ilyakolb/ilyakolb.github.io/_publications/jgcamp8_paper.md

---
title: "Fast and sensitive GCaMP calcium indicators for imaging neural populations"
collection: publications
permalink: jgcamp8_paper
excerpt: 'Calcium imaging with protein-based indicators1,2 is widely used to follow neural activity in intact nervous systems, but current protein sensors report neural activity at timescales much slower than electrical signalling and are limited by trade-offs between sensitivity and kinetics. Here we used large-scale screening and structure-guided mutagenesis to develop and optimize several fast and sensitive GCaMP-type indicators3–8. The resulting ‘jGCaMP8’ sensors, based on the calcium-binding protein calmodulin and a fragment of endothelial nitric oxide synthase, have ultra-fast kinetics (half-rise times of 2 ms) and the highest sensitivity for neural activity reported for a protein-based calcium sensor. jGCaMP8 sensors will allow tracking of large populations of neurons on timescales relevant to neural computation. [<a href="https://www.nature.com/articles/d41586-023-00704-y/"><b>[News and Views]</b></a>'
date: March 2023
venue: 'Nature'
paperurl: 'https://www.nature.com/articles/d41586-023-00704-y.pdf'
citation: 'Zhang, Yan, Márton Rózsa, Yajie Liang, Daniel Bushey, Ziqiang Wei, Jihong Zheng, Daniel Reep, et al. “Fast and Sensitive GCaMP Calcium Indicators for Imaging Neural Populations.” <i>Nature</i> 615, no. 7954 (March 2023): 884–91. https://doi.org/10.1038/s41586-023-05828-9.'

---
