ilyakolb/ilyakolb.github.io/patcherBot.md

---
title: "PatcherBot: walk-away automated patch-clamp robotics"
excerpt: "PatcherBot: walk-away automated patch-clamp robotics"
sitemap: true
permalink: /patcherBot/
author_profile: true
---

## About
 - Enables automated patch-clamp recordings in cultured cells, brain slices and *in vivo*
 - Autonomously performs experiments for 3+ hours with no human intervention
 - Uses computer vision and automated pipette cleaning to close the loop

## Demonstration video
<iframe width="560" height="315" src="https://www.youtube.com/embed/nqFYfrU-XBE" title="YouTube video player" frameborder="0" allow="accelerometer; autoplay; clipboard-write; encrypted-media; gyroscope; picture-in-picture" allowfullscreen></iframe>

*Two pipettes independently patch-clamp multiple HEK cells on a glass cover slip sequentially without human intervention over the span of 27 minutes. Green light indicates successful whole-cell recording.*

### Other patcherBot videos
[[Timelapse experiment](https://www.youtube.com/watch?v=CGZxwwHRhpE)]
[[In vivo experiment](https://www.youtube.com/watch?v=CGZxwwHRhpE)]
[[Single-pipette experiment](https://www.youtube.com/watch?v=CGZxwwHRhpE)]

## Details

For more details on implementation, see the [PatcherBot paper](https://iopscience.iop.org/article/10.1088/1741-2552/ab1834) and the [pipette cleaning paper](https://www.nature.com/articles/srep35001)
