ilyakolb/ilyakolb.github.io/wellStim.md

---
title: "wellStim: current stimulator for 24-well plates"
excerpt: "wellStim: current stimulator for 24-well plates"
sitemap: true
permalink: /wellStim/
author_profile: true
---

## About
 - Provides ability to easily program stimulation sequences to be delivered to each well
 - Compatible with simultaneous imaging and drug delivery
 - Integrates with Micro-Manager for fully automated plate acquisition
 - Can be controlled by software or in standalone mode, making it easily portable 
 - Advanced features (trigger in/out, sync pulses)
