ilyakolb/ilyakolb.github.io/_publications/igaba2_preprint.md

---
title: "Improved GABA (γ-aminobutyric acid) Indicators for Synaptic Imaging"
collection: publications
permalink: igaba2_preprint
excerpt: 'iGABASnFR2 is the current (2022) generation of GABA-Sensing Fluorescent Reporters developed at HHMI''s Janelia Research Campus. Other sensor technologies such as SF-iGluSnFR, jGCaMP8, and jRGECO are optimized for excitatory synaptic transmission and action potentials. iGABASnFr complements these technologies with the ability to detect inhibitory synaptic transmission and inhibitory post-synaptic currents. iGABASnFr2 has the best performance among GABA indicators and is completely genetically coded, which is optimal for in vivo use.'
date: September 2022
venue: 'Figshare'
paperurl: 'https://janelia.figshare.com/articles/dataset Optimization_of_genetically_encoded_GABA_indicator/19709311'
citation: 'Kolb, Ilya; Hasseman, Jeremy; Tsegaye, Getahun; Tsang, Arthur; Reep, Daniel; Zheng, Jihong; et al. (2022). Optimization of genetically encoded GABA indicator. Janelia Research Campus. Dataset. https://doi.org/10.25378/janelia.19709311.v3'

---
