ilyakolb/ilyakolb.github.io/projects/96well/images/MIB-box-back.png

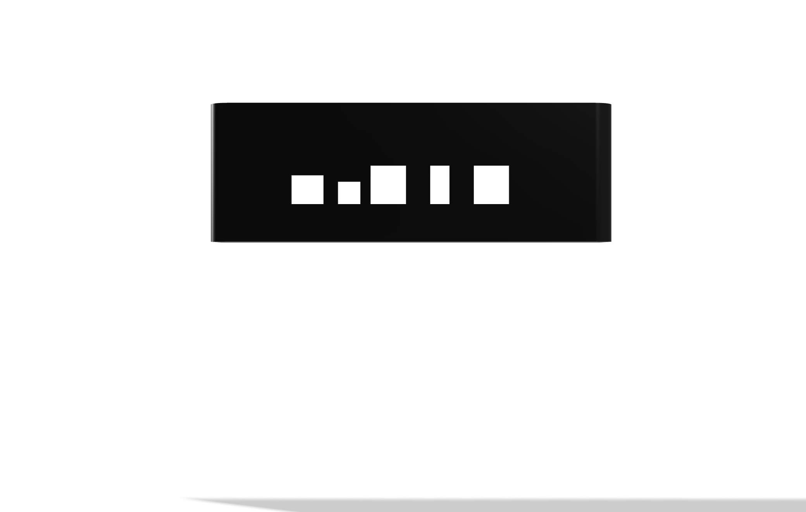
projects/96well/images/MIB-box-back.png
