ilyakolb/ilyakolb.github.io/projects/96well/images/MIB-box-front.png

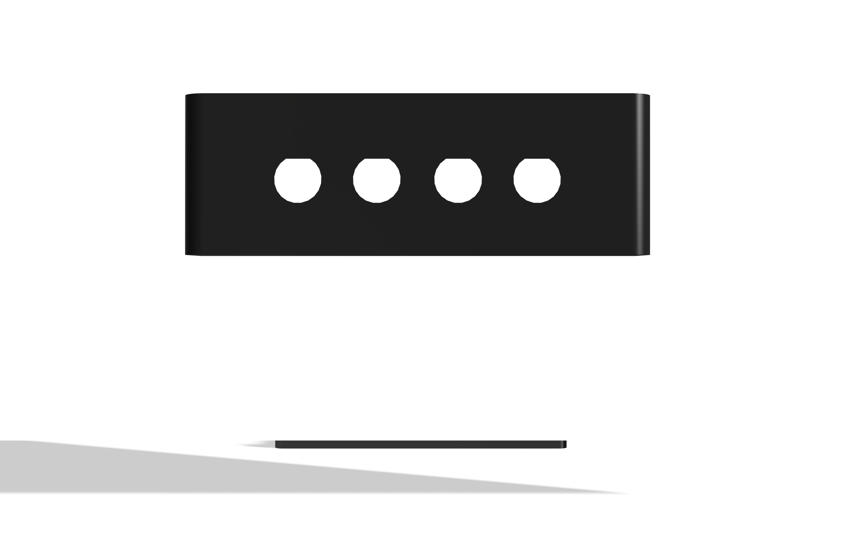
projects/96well/images/MIB-box-front.png
