ilyakolb/ilyakolb.github.io/projects/96well/images/MIB-box-top.png

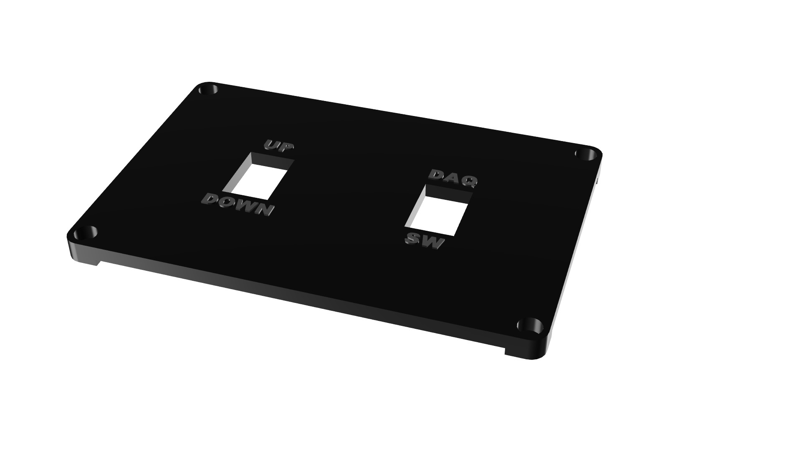
projects/96well/images/MIB-box-top.png
