ilyakolb/ilyakolb.github.io/projects/96well/ECAD/MIB_BOM.xlsx

Sheet: prelim-bom
Reference | Value | Footprint | Datasheet | Sim.Device | Sim.Pins | Qty | Part number (Digikey; Mouser where indicated)
R3, R4, R9, R10 | 330 | Resistor_THT:R_Axial_DIN0204_L3.6mm_D1.6mm_P7.62mm_Horizontal | ~ |  |  | 4 | Have
R1, R2, R5-R8 | 10k | Resistor_THT:R_Axial_DIN0204_L3.6mm_D1.6mm_P7.62mm_Horizontal | ~ |  |  | 6 | Have
D1, D2 | 1N4001 | Diode_THT:D_DO-41_SOD81_P10.16mm_Horizontal | http://www.vishay.com/docs/88503/1n4001.pdf | D | 1=K 2=A | 2 | Have
PWR_IN1 | Barrel_Jack_MountingPin | Connector_BarrelJack:BarrelJack_CUI_PJ-063AH_Horizontal_CircularHoles | ~ |  |  | 1 | PJ-063AH
DAQ_IN_DWN1 | Conn_Coaxial | Connector_Coaxial:BNC_Amphenol_B6252HB-NPP3G-50_Horizontal | ~ |  |  | 1 | ARF1691-ND
DAQ_IN_UP1 | Conn_Coaxial | Connector_Coaxial:BNC_Amphenol_B6252HB-NPP3G-50_Horizontal | ~ |  |  | 1 | ARF1691-ND
DWN_LIM_OUT1 | Conn_Coaxial | Connector_Coaxial:BNC_Amphenol_B6252HB-NPP3G-50_Horizontal | ~ |  |  | 1 | ARF1691-ND
UP_LIM_OUT1 | Conn_Coaxial | Connector_Coaxial:BNC_Amphenol_B6252HB-NPP3G-50_Horizontal | ~ |  |  | 1 | ARF1691-ND
DWN_RLY1 | FINDER-34.51 | Relay_THT:Relay_SPDT_Finder_34.51_Vertical | https://gfinder.findernet.com/public/attachments/34/EN/S34USAEN.pdf |  |  | 1 | APF30305 (Mouser)
UP_RLY1 | FINDER-34.51 | Relay_THT:Relay_SPDT_Finder_34.51_Vertical | https://gfinder.findernet.com/public/attachments/34/EN/S34USAEN.pdf |  |  | 1 | APF30305 (Mouser)
Q1-Q4 | IRLB8721PBF | Package_TO_SOT_THT:TO-220-3_Vertical | http://www.infineon.com/dgdl/irlb8721pbf.pdf?fileId=5546d462533600a40153566056732591 |  |  | 4 | IRLB8721PBF-ND
M1 | Motor_DC_ALT | TerminalBlock_Phoenix:TerminalBlock_Phoenix_MPT-0,5-2-2.54_1x02_P2.54mm_Horizontal | ~ |  |  | 1 | 277-1273-ND
DWN_LIM1 | PM-25 | TerminalBlock_Phoenix:TerminalBlock_Phoenix_MPT-0,5-4-2.54_1x04_P2.54mm_Horizontal |  |  |  | 1 | 277-1275-ND
UP_LIM1 | PM-25 | TerminalBlock_Phoenix:TerminalBlock_Phoenix_MPT-0,5-4-2.54_1x04_P2.54mm_Horizontal |  |  |  | 1 | 277-1275-ND
SW_DAQ_OR_MAN_1 | SW_DAQ_OR_MAN | TerminalBlock_Phoenix:TerminalBlock_Phoenix_MPT-0,5-6-2.54_1x06_P2.54mm_Horizontal | ~ |  |  | 1 | 277-1277-ND
SW_DWN_LIM_EN1 | SW_DIP_x02 | Button_Switch_THT:SW_DIP_SPSTx02_Slide_6.7x6.64mm_W7.62mm_P2.54mm_LowProfile | ~ |  |  | 1 | 2223-DS01-254-S-02BE-ND
SW_UP_LIM_EN1 | SW_DIP_x02 | Button_Switch_THT:SW_DIP_SPSTx02_Slide_6.7x6.64mm_W7.62mm_P2.54mm_LowProfile | ~ |  |  | 1 | 2223-DS01-254-S-02BE-ND
SW_UPDWN1 | SW_Push_SPDT | TerminalBlock_Phoenix:TerminalBlock_Phoenix_MPT-0,5-3-2.54_1x03_P2.54mm_Horizontal | ~ |  |  | 1 | 277-1274-ND

Sheet: v2.0
Reference | Value | Footprint | Qty | Part number (Digikey; Mouser where indicated)
R5-R7 | 330 | Resistor_THT:R_Axial_DIN0204_L3.6mm_D1.6mm_P7.62mm_Horizontal | 4 | S330HTR-ND
R1-R4 | 10k | Resistor_THT:R_Axial_DIN0204_L3.6mm_D1.6mm_P7.62mm_Horizontal | 6 | S10KHTR-ND
D1, D2 | 1N4001 | Diode_THT:D_DO-41_SOD81_P10.16mm_Horizontal | 2 | 2156-1N4001-FSTR-ND
PWR_IN1 | Barrel_Jack_MountingPin | Connector_BarrelJack:BarrelJack_CUI_PJ-063AH_Horizontal_CircularHoles | 1 | PJ-063AH
DAQ_IN_DWN1 | Conn_Coaxial | Connector_Coaxial:BNC_Amphenol_B6252HB-NPP3G-50_Horizontal | 1 | ARF1691-ND
DAQ_IN_UP1 | Conn_Coaxial | Connector_Coaxial:BNC_Amphenol_B6252HB-NPP3G-50_Horizontal | 1 | ARF1691-ND
DWN_LIM_OUT1 | Conn_Coaxial | Connector_Coaxial:BNC_Amphenol_B6252HB-NPP3G-50_Horizontal | 1 | ARF1691-ND
UP_LIM_OUT1 | Conn_Coaxial | Connector_Coaxial:BNC_Amphenol_B6252HB-NPP3G-50_Horizontal | 1 | ARF1691-ND
DWN_RLY1 | FINDER-34.51 | Relay_THT:Relay_SPDT_Finder_34.51_Vertical | 1 | APF30305 (Mouser)
UP_RLY1 | FINDER-34.51 | Relay_THT:Relay_SPDT_Finder_34.51_Vertical | 1 | APF30305 (Mouser)
Q1-Q2 |  | Package_TO_SOT_THT:TO-220-3_Vertical | 4 | IRLB8721PBF-ND
M1 | Motor_DC_ALT | TerminalBlock_Phoenix:TerminalBlock_Phoenix_MPT-0,5-2-2.54_1x02_P2.54mm_Horizontal | 1 | 277-1273-ND
DWN_LIM1 | PM-25 | TerminalBlock_Phoenix:TerminalBlock_Phoenix_MPT-0,5-4-2.54_1x04_P2.54mm_Horizontal | 1 | 277-1275-ND
UP_LIM1 | PM-25 | TerminalBlock_Phoenix:TerminalBlock_Phoenix_MPT-0,5-4-2.54_1x04_P2.54mm_Horizontal | 1 | 277-1275-ND
SW_DAQ_OR_MAN_1 | SW_DAQ_OR_MAN | TerminalBlock_Phoenix:TerminalBlock_Phoenix_MPT-0,5-6-2.54_1x06_P2.54mm_Horizontal | 1 | 277-1277-ND
SW_DWN_LIM_EN1 | SW_DIP_x02 | Button_Switch_THT:SW_DIP_SPSTx02_Slide_6.7x6.64mm_W7.62mm_P2.54mm_LowProfile | 1 | 2223-DS01-254-S-02BE-ND
SW_UP_LIM_EN1 | SW_DIP_x02 | Button_Switch_THT:SW_DIP_SPSTx02_Slide_6.7x6.64mm_W7.62mm_P2.54mm_LowProfile | 1 | 2223-DS01-254-S-02BE-ND
SW_UPDWN1 | SW_Push_SPDT | TerminalBlock_Phoenix:TerminalBlock_Phoenix_MPT-0,5-3-2.54_1x03_P2.54mm_Horizontal | 1 | 277-1274-ND
N/A | 5V/5W power supply | N/A | 1 | GS06U-1P1J

Sheet: v1.0
Status | # | Reference | Qty | Value | Footprint | DNP
Not placed | 1 | C1 | 1 | 10uF | Capacitor_THT:CP_Radial_D5.0mm_P2.50mm
Not placed | 2 | C2 | 1 | 0.1uF | Capacitor_THT:C_Axial_L3.8mm_D2.6mm_P7.50mm_Horizontal
Not placed | 3 | D1, D2 | 2 | 1N4001 | Diode_THT:D_DO-41_SOD81_P10.16mm_Horizontal
Placed | 4 | D3 | 1 | LED | ik_lib:LED_W6mm_L9.2mm_Pitch2.54mm
Placed | 5 | DAQ_IN_DWN1, DAQ_IN_UP1, DWN_LIM_OUT1, UP_LIM_OUT1 | 4 | Conn_Coaxial | Connector_Coaxial:BNC_Amphenol_B6252HB-NPP3G-50_Horizontal
Placed | 6 | DWN_LIM1, UP_LIM1 | 2 | PM-25 | TerminalBlock_Phoenix:TerminalBlock_Phoenix_MPT-0,5-4-2.54_1x04_P2.54mm_Horizontal
Placed | 7 | DWN_RLY1, UP_RLY1 | 2 | FINDER-34.51 | Relay_THT:Relay_SPDT_Finder_34.51_Vertical
Placed | 8 | M1 | 1 | Motor_DC_ALT | TerminalBlock_Phoenix:TerminalBlock_Phoenix_MPT-0,5-2-2.54_1x02_P2.54mm_Horizontal
Placed | 9 | PWR_IN1 | 1 | Barrel_Jack_MountingPin | Connector_BarrelJack:BarrelJack_CUI_PJ-063AH_Horizontal_CircularHoles
Placed | 10 | Q1, Q2, Q3, Q4 | 4 | IRLB8721PBF | Package_TO_SOT_THT:TO-220-3_Vertical
Not placed | 11 | R1, R2, R5, R6, R7, R8 | 6 | 10k | Resistor_THT:R_Axial_DIN0204_L3.6mm_D1.6mm_P7.62mm_Horizontal
Not placed | 12 | R3, R4, R9, R10, R11 | 5 | 330 | Resistor_THT:R_Axial_DIN0204_L3.6mm_D1.6mm_P7.62mm_Horizontal
Placed | 13 | SW_DAQ_OR_MAN_1 | 1 | SW_DAQ_OR_MAN | TerminalBlock_Phoenix:TerminalBlock_Phoenix_MPT-0,5-6-2.54_1x06_P2.54mm_Horizontal
Placed | 14 | SW_DWN_LIM_EN1, SW_UP_LIM_EN1 | 2 | SW_DIP_x02 | Button_Switch_THT:SW_DIP_SPSTx02_Slide_6.7x6.64mm_W7.62mm_P2.54mm_LowProfile
Placed | 15 | SW_UPDWN1 | 1 | SW_Push_SPDT | TerminalBlock_Phoenix:TerminalBlock_Phoenix_MPT-0,5-3-2.54_1x03_P2.54mm_Horizontal
