ilyakolb/ilyakolb.github.io/projects/96well/CAD/MIB-lid.stl

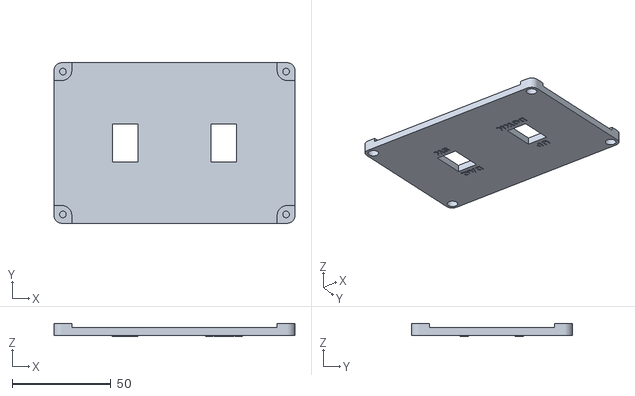
[picture p11: CAD file, 2024-07-17]
projects/96well/CAD/MIB-lid.stl
121.9 x 81.3 x 6.50
