ilyakolb/ilyakolb.github.io/projects/96well/CAD/actuator-mounting-bracket-v39.stl

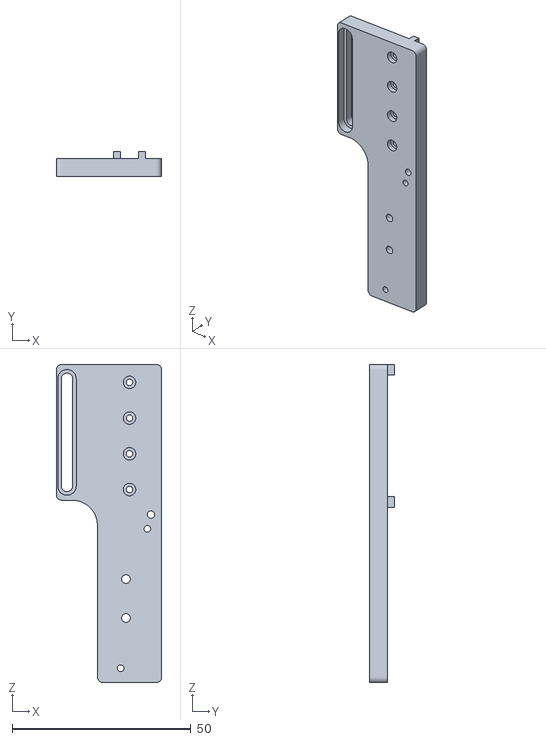
[picture p12: CAD file, 2024-07-17]
projects/96well/CAD/actuator-mounting-bracket-v39.stl
29.5 x 7.00 x 89.0
