ilyakolb/ilyakolb.github.io/projects/96well/CAD/actuator-retention-bracket-v2.stl

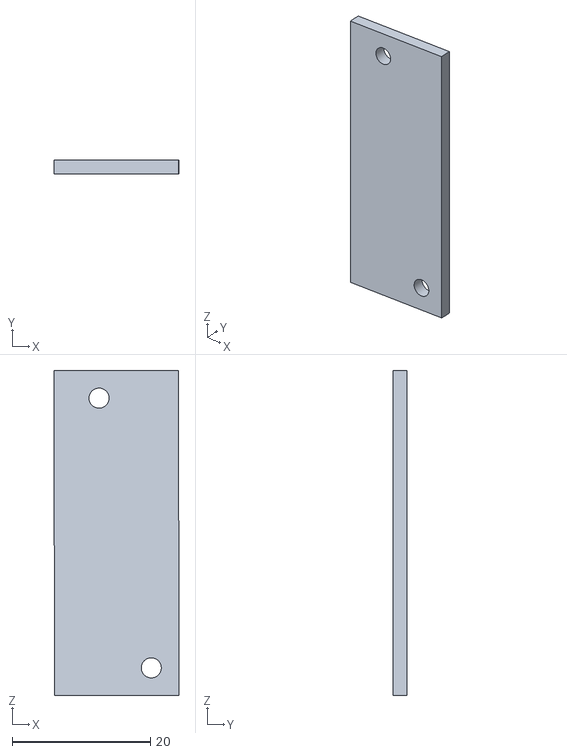
[picture p13: CAD file, 2024-07-17]
projects/96well/CAD/actuator-retention-bracket-v2.stl
18.1 x 2.00 x 47.0
