ilyakolb/ilyakolb.github.io/projects/96well/CAD/electrode-carriage-v20.stl

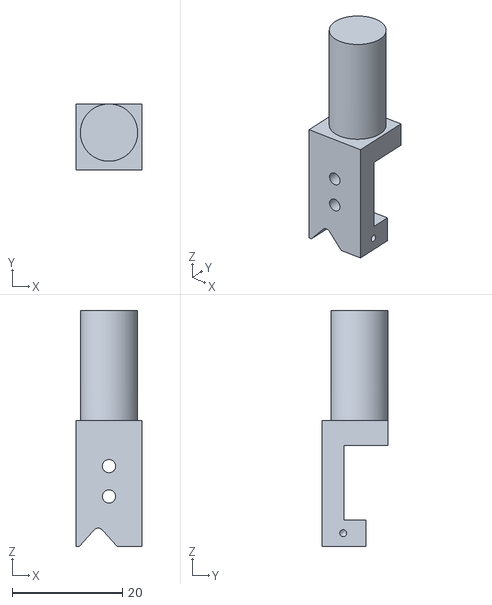
[picture p14: CAD file, 2024-07-17]
projects/96well/CAD/electrode-carriage-v20.stl
11.9 x 12.0 x 42.8
