ilyakolb/ilyakolb.github.io/projects/96well/CAD/condenser-mount-v12.stl

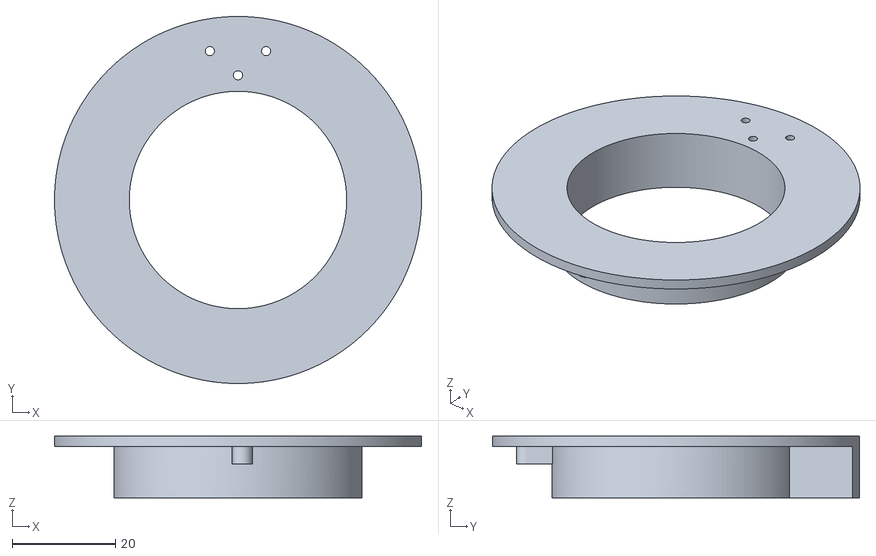
[picture p15: CAD file, 2024-07-17]
projects/96well/CAD/condenser-mount-v12.stl
71.1 x 71.1 x 12.0
