ilyakolb/ilyakolb.github.io/projects/96well/CAD/MIB-body.stl

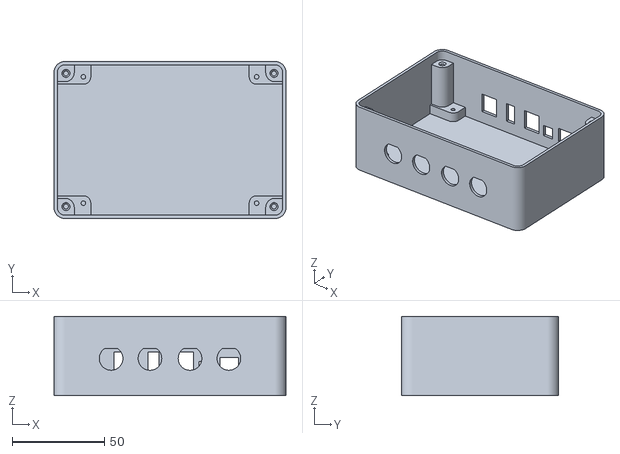
[picture p16: CAD file, 2024-07-17]
projects/96well/CAD/MIB-body.stl
125.9 x 85.3 x 43.0
