ilyakolb/ilyakolb.github.io/projects/96well/CAD/electrode-housing-v5.stl

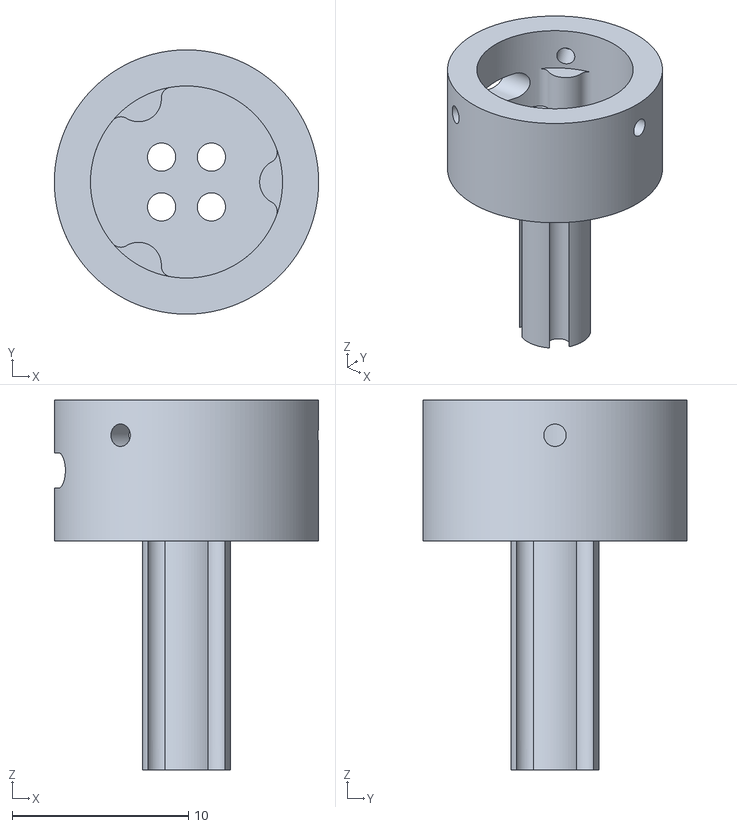
[picture p17: CAD file, 2024-07-17]
projects/96well/CAD/electrode-housing-v5.stl
15.0 x 15.0 x 21.0
