ilyakolb/ilyakolb.github.io/projects/96well/ECAD/interface-board.kicad_pcb

## KiCad design projects/96well/ECAD/interface-board.kicad_pcb (2024-07-17)

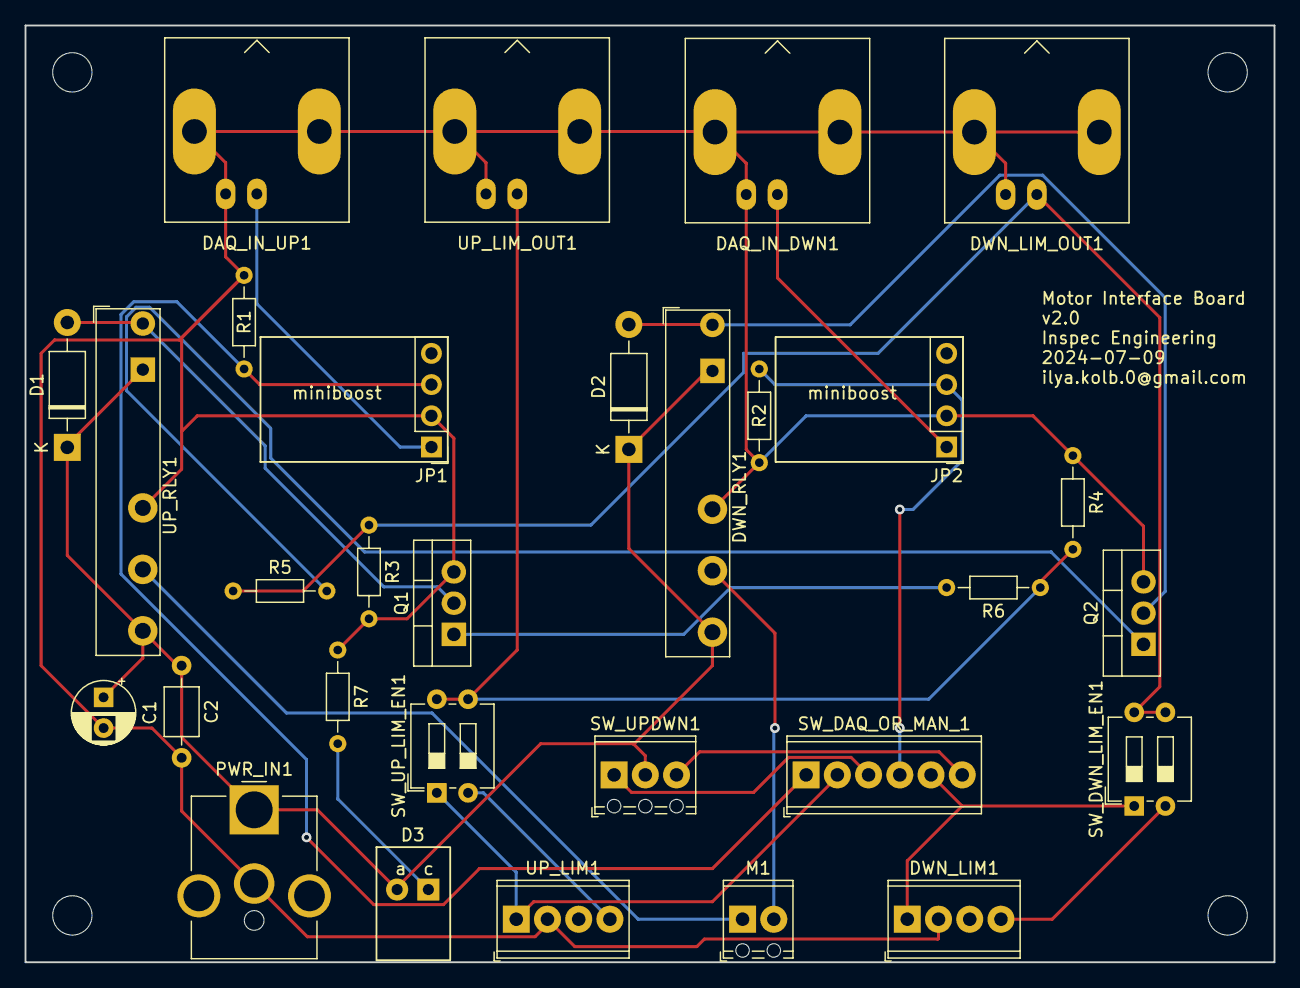
[picture p18: board interface-board.kicad_pcb from above]

Board: 2 copper layers, 101.6 x 76.2 mm, 30 parts (0 on the bottom side), 21 nets.

Parts:
C1: 10uF; CP_Radial_D5.0mm_P2.50mm
C2: 0.1uF; C_Axial_L3.8mm_D2.6mm_P7.50mm_Horizontal
D1, D2: 1N4001; D_DO-41_SOD81_P10.16mm_Horizontal
D3: LED; LED_W6mm_L9.2mm_Pitch2.54mm
DAQ_IN_DWN1: Conn_Coaxial; BNC_Amphenol_B6252HB-NPP3G-50_Horizontal
DAQ_IN_UP1: Conn_Coaxial; BNC_Amphenol_B6252HB-NPP3G-50_Horizontal
DWN_LIM1: PM-25; TerminalBlock_Phoenix_MPT-0,5-4-2.54_1x04_P2.54mm_Horizontal
DWN_LIM_OUT1: Conn_Coaxial; BNC_Amphenol_B6252HB-NPP3G-50_Horizontal
DWN_RLY1: FINDER-34.51; Relay_SPDT_Finder_34.51_Vertical
JP1, JP2: HEADER-1X4ROUND; PinHeader_1x04_P2.54mm_Vertical
M1: Motor_DC_ALT; TerminalBlock_Phoenix_MPT-0,5-2-2.54_1x02_P2.54mm_Horizontal
PWR_IN1: Barrel_Jack_MountingPin; BarrelJack_CUI_PJ-063AH_Horizontal_CircularHoles
Q1, Q2: IRLB8721PBF; TO-220-3_Vertical
R1, R2, R3, R4: 10k; R_Axial_DIN0204_L3.6mm_D1.6mm_P7.62mm_Horizontal
R5, R6, R7: 330; R_Axial_DIN0204_L3.6mm_D1.6mm_P7.62mm_Horizontal
SW_DAQ_OR_MAN_1: SW_DAQ_OR_MAN; TerminalBlock_Phoenix_MPT-0,5-6-2.54_1x06_P2.54mm_Horizontal
SW_DWN_LIM_EN1: SW_DIP_x02; SW_DIP_SPSTx02_Slide_6.7x6.64mm_W7.62mm_P2.54mm_LowProfile
SW_UPDWN1: SW_Push_SPDT; TerminalBlock_Phoenix_MPT-0,5-3-2.54_1x03_P2.54mm_Horizontal
SW_UP_LIM_EN1: SW_DIP_x02; SW_DIP_SPSTx02_Slide_6.7x6.64mm_W7.62mm_P2.54mm_LowProfile
UP_LIM1: PM-25; TerminalBlock_Phoenix_MPT-0,5-4-2.54_1x04_P2.54mm_Horizontal
UP_LIM_OUT1: Conn_Coaxial; BNC_Amphenol_B6252HB-NPP3G-50_Horizontal
UP_RLY1: FINDER-34.51; Relay_SPDT_Finder_34.51_Vertical

Connections:
GND: C1.2, C2.2, DAQ_IN_DWN1.2 (Ext), DAQ_IN_UP1.2 (Ext), DWN_LIM1.2 (GND), DWN_LIM_OUT1.2 (Ext), DWN_RLY1.12, JP1.2 (GND), JP2.2 (GND), PWR_IN1.2, Q1.3 (S), Q2.3 (S), R1.1, R2.1, R3.2, R4.1, R7.1, UP_LIM1.2 (GND), UP_LIM_OUT1.2 (Ext), UP_RLY1.12
unnamed: D1.2 (A), Q1.2 (D), UP_RLY1.A2
unnamed: D2.2 (A), DWN_RLY1.A2, Q2.2 (D)
unnamed: D3.1 (K), R7.2
unnamed: DAQ_IN_DWN1.1 (In), JP2.1 (VIN)
unnamed: DAQ_IN_UP1.1 (In), JP1.1 (VIN)
unnamed: DWN_LIM1.1 (+V), SW_DAQ_OR_MAN_1.5 (B), SW_DWN_LIM_EN1.1
unnamed: DWN_LIM1.4 (OUT1), SW_DWN_LIM_EN1.2
unnamed: DWN_LIM_OUT1.1 (In), R3.1, R5.1, SW_DWN_LIM_EN1.3, SW_DWN_LIM_EN1.4
unnamed: JP1.3 (VO), R1.2, SW_DAQ_OR_MAN_1.1 (A)
unnamed: JP2.3 (VO), R2.2, SW_DAQ_OR_MAN_1.4 (A)
unnamed: M1.1 (+), UP_RLY1.11
unnamed: DWN_RLY1.11, M1.2 (-)
unnamed: Q1.1 (G), R6.2
unnamed: Q2.1 (G), R5.2
unnamed: SW_DAQ_OR_MAN_1.2 (B), SW_UP_LIM_EN1.1, UP_LIM1.1 (+V)
unnamed: SW_DAQ_OR_MAN_1.3 (C), SW_UPDWN1.1 (A)
unnamed: SW_DAQ_OR_MAN_1.6 (C), SW_UPDWN1.3 (C)
unnamed: SW_UP_LIM_EN1.2, UP_LIM1.4 (OUT1)
unnamed: R4.2, R6.1, SW_UP_LIM_EN1.3, SW_UP_LIM_EN1.4, UP_LIM_OUT1.1 (In)
VCC: C1.1, C2.1, D1.1 (K), D2.1 (K), D3.2 (A), DWN_RLY1.14, DWN_RLY1.A1, PWR_IN1.1, SW_UPDWN1.2 (B), UP_RLY1.14, UP_RLY1.A1
